vaishnavvrao/Arduino-Heart-Monitor/README.md

# Arduino-Heart-Monitor
Arduino microcontroller project to detect pulse rate, SpO2, and display diagnosis

Project Members: Vaishnav V. Rao, Harshda Saxena, Manan Seth
